tarantula3/Indoor-Dial-Thermometer/Schema_bb.png

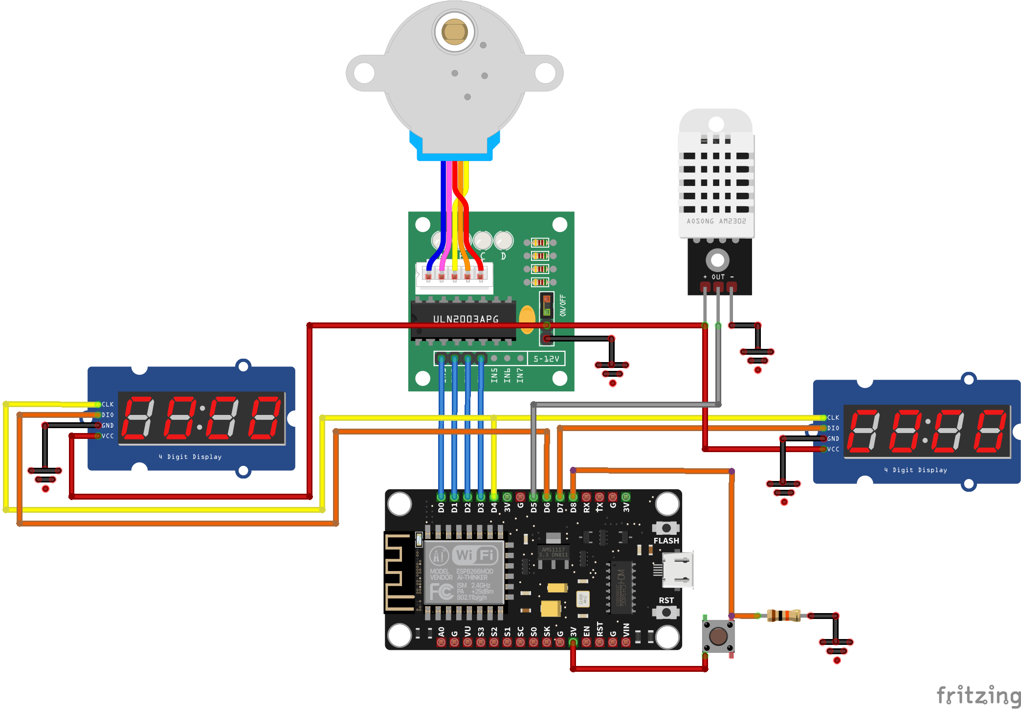
Schema_bb.png
